dadoftwins/WarlockStaff/WarlockStaff/WarlockStaff.ino

////////////////////////////////////////////////////////////////////////
// -=- Warlock|Staff -=-
//////////////////////////

#include <WarlockStaff.h>

////////////////////////////////////////////////////////////////////////
// Main object
//////////////////////////

WarlockStaff warlockStaff;

////////////////////////////////////////////////////////////////////////
// Functions
//////////////////////////

void setup()
{
    warlockStaff.setup();
}

void loop()
{
    warlockStaff.loop();
}
